lpkpaco/gadget32/releases/v0.8.0-alpha/PCB.obj

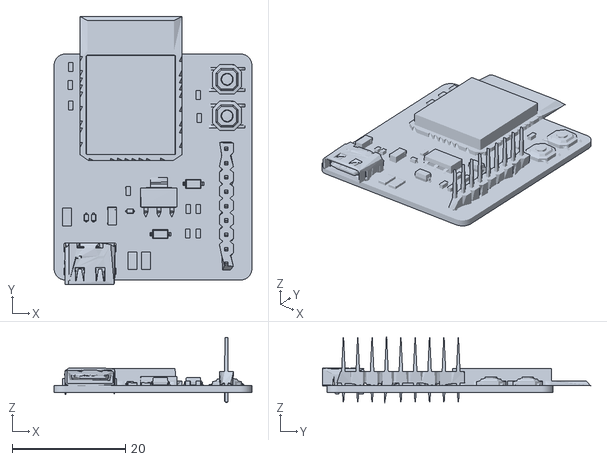
[picture p1: CAD file, 2026-10-26]
releases/v0.8.0-alpha/PCB.obj
35.0 x 47.4 x 11.5
