lpkpaco/gadget32/releases/v0.8.0-alpha/desktop_shell.3mf

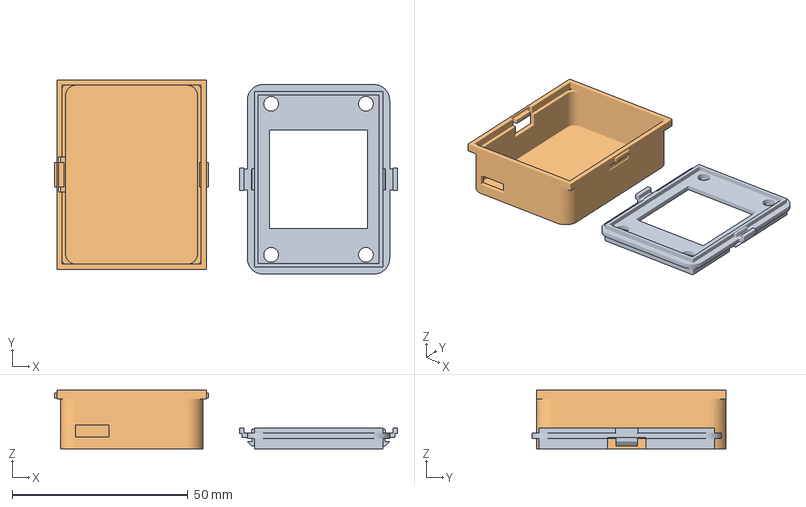
[picture p2: CAD file, 2026-10-26]
releases/v0.8.0-alpha/desktop_shell.3mf
97.7 x 55.3 x 16.7 mm
GadgetLid
GadgetShell
