lpkpaco/gadget32/SCH_gadget32-v1_0.pdf

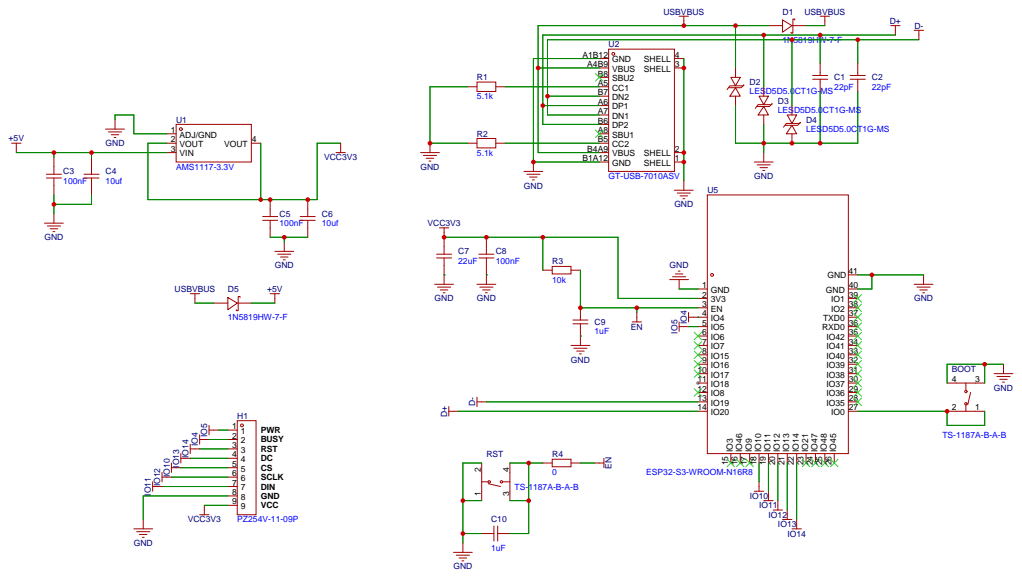
[picture p3: page 1]

SHELL 1 GND B1A12 VBUS B4A9 CC2 B5 SBU1 A8 DP2 B6 DN1 A7 DP1 A6 DN2 B7 CC1 A5 SBU2 B8 VBUS A4B9 GND A1B12
