lpkpaco/gadget32/upload_s3/ImageData.cpp

#include "ImageData.h"

const unsigned char Image6color[] = {
  0x31, 0x35, 0x31, 0x32, 0x42, 0x31, 0x32, 0x42, 0x31, 0x32, 0x42, 0x31, 0x32, 0x42, 0x31, 0x35,
  0x31, 0x35, 0x31, 0x03, 0x10, 0x31, 0x03, 0x10, 0x35, 0x34, 0x20, 0x31, 0x11, 0x31, 0x11, 0x21,
  0x31, 0x32, 0x31, 0x32, 0x31, 0x30, 0x13, 0x23, 0x13, 0x23, 0x13, 0x23, 0x13, 0x23, 0x13, 0x23,
  0x13, 0x23, 0x13, 0x23, 0x13, 0x23, 0x13, 0x23, 0x13, 0x23, 0x13, 0x23, 0x13, 0x31, 0x32, 0x31,
  0x32, 0x31, 0x32, 0x31, 0x32, 0x31, 0x32, 0x31, 0x32, 0x31, 0x32, 0x31, 0x32, 0x31, 0x32, 0x31,
  0x32, 0x31, 0x32, 0x31, 0x32, 0x31, 0x31, 0x11, 0x21, 0x11, 0x30, 0x35, 0x43, 0x00, 0x01, 0x00,
  0x04, 0x00, 0x00, 0x00, 0x00, 0x40, 0x30, 0x45, 0x03, 0x40, 0x50, 0x34, 0x05, 0x03, 0x45, 0x34,
  0x24, 0x20, 0x10, 0x01, 0x00, 0x00, 0x40, 0x00, 0x02, 0x43, 0x10, 0x10, 0x24, 0x24, 0x24, 0x23,
  0x42, 0x42, 0x31, 0x03, 0x42, 0x34, 0x20, 0x13, 0x42, 0x43, 0x10, 0x13, 0x01, 0x30, 0x10, 0x31,
  0x01, 0x32, 0x43, 0x10, 0x13, 0x11, 0x31, 0x31, 0x31, 0x01, 0x34, 0x24, 0x30, 0x13, 0x31, 0x34,
  0x23, 0x42, 0x34, 0x13, 0x34, 0x13, 0x34, 0x13, 0x34, 0x13, 0x34, 0x13, 0x34, 0x13, 0x34, 0x13,
  0x34, 0x13, 0x34, 0x13, 0x31, 0x02, 0x43, 0x13, 0x43, 0x13, 0x43, 0x13, 0x43, 0x13, 0x43, 0x13,
  0x42, 0x43, 0x13, 0x42, 0x43, 0x13, 0x41, 0x33, 0x41, 0x34, 0x24, 0x31, 0x34, 0x23, 0x13, 0x31,
  0x31, 0x31, 0x11, 0x43, 0x05, 0x42, 0x40, 0x34, 0x20, 0x24, 0x24, 0x24, 0x24, 0x20, 0x54, 0x20,
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
  0x43, 0x13, 0x10, 0x13, 0x31, 0x31, 0x01, 0x31, 0x34, 0x23, 0x13, 0x13, 0x42, 0x34, 0x23, 0x10,
  0x31, 0x13, 0x11, 0x31, 0x31, 0x34, 0x23, 0x42, 0x31, 0x34, 0x24, 0x24, 0x23, 0x42, 0x31, 0x03,
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

};
